jacoirone/ARCHIE/Figures/TSPCB_all.png

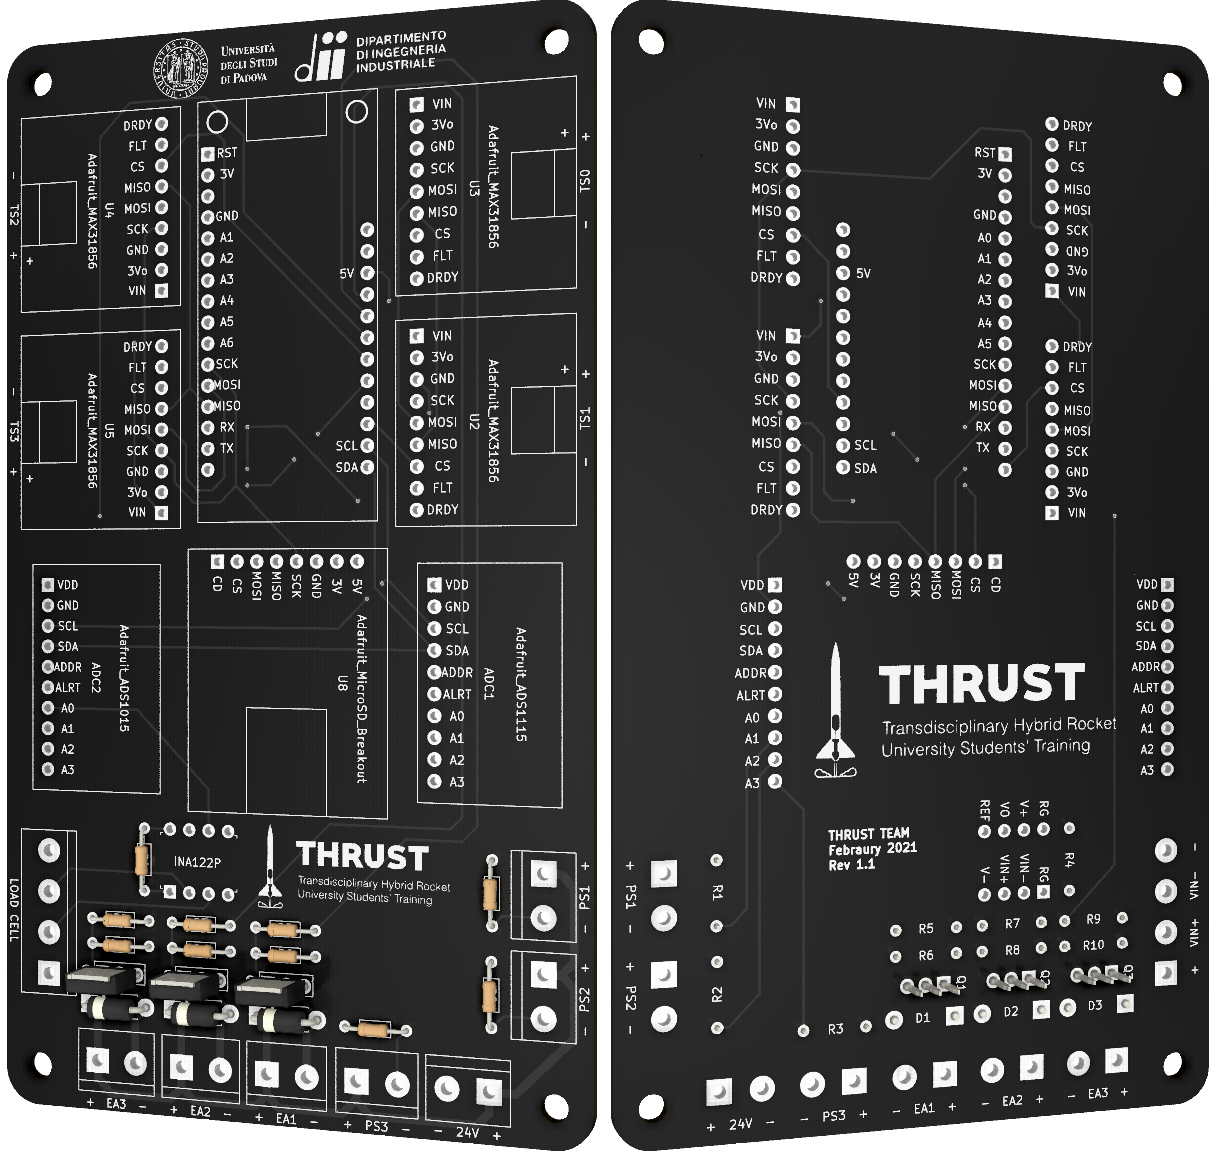
Figures/TSPCB_all.png
