jacoirone/ARCHIE/Figures/TSPCB_Back.PNG

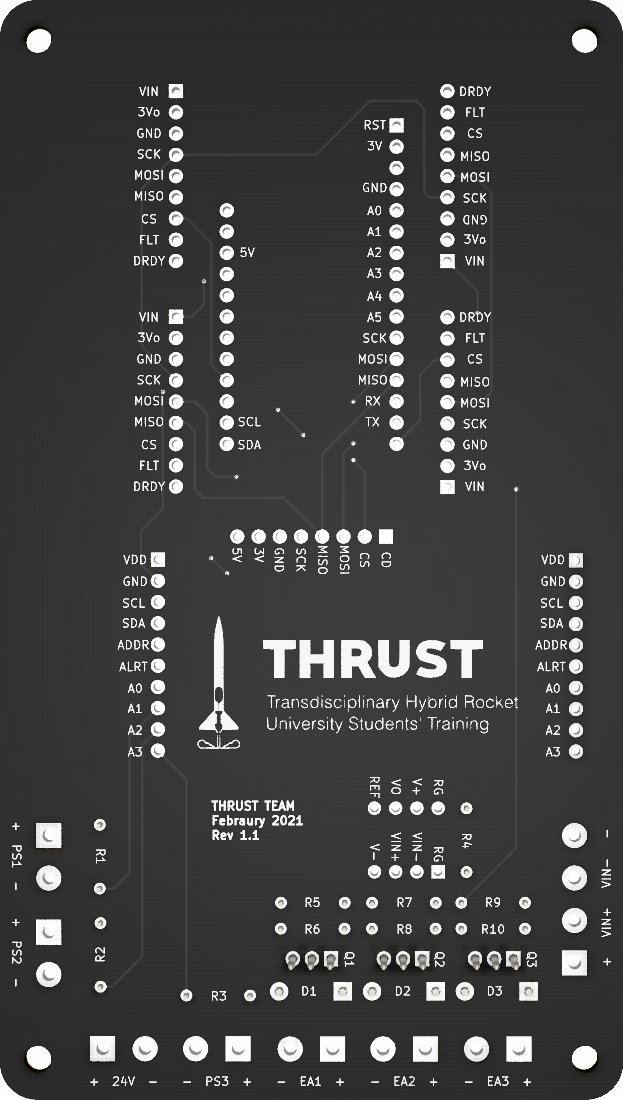
Figures/TSPCB_Back.PNG
