jacoirone/ARCHIE/Figures/TSPCB_Front.PNG

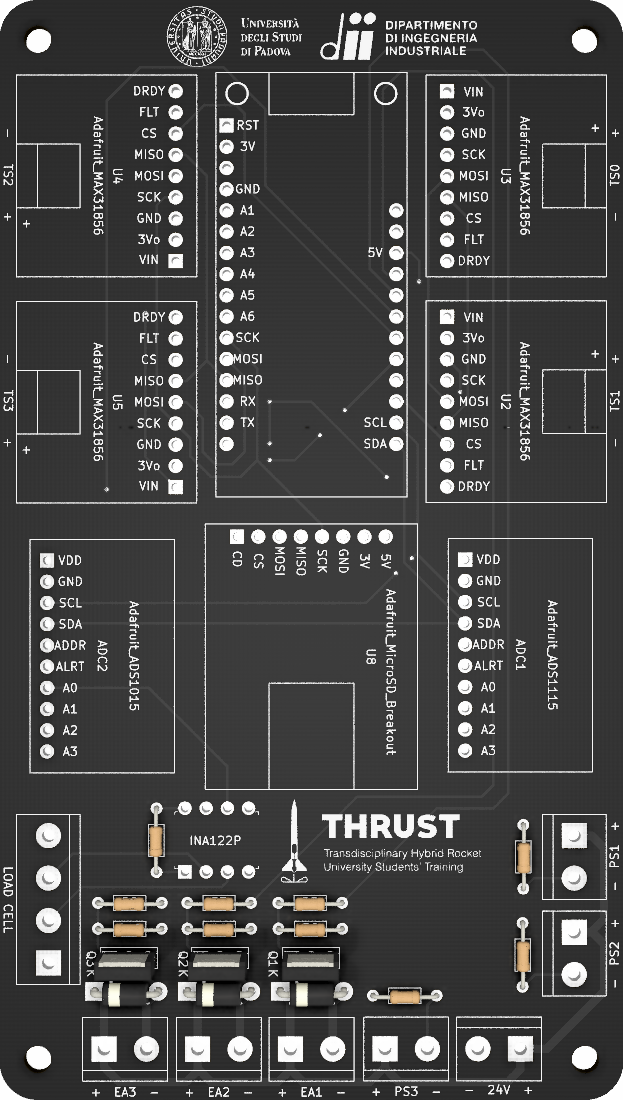
Figures/TSPCB_Front.PNG
