jacoirone/ARCHIE/(commit log)

2023-05-15 First Commit, reupload to a public repo
    [Components Selection.xlsx, Test 1-2-3 Schematic.sch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]
2023-05-15 Cleanup and moving ARCHIE to the first folder
    [Components Selection.xlsx, Test 1-2-3 Schematic.sch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]
